dl1bz/ESP32-XPA125B-Webcontrol/XPA125B-MB-Assembly.pdf

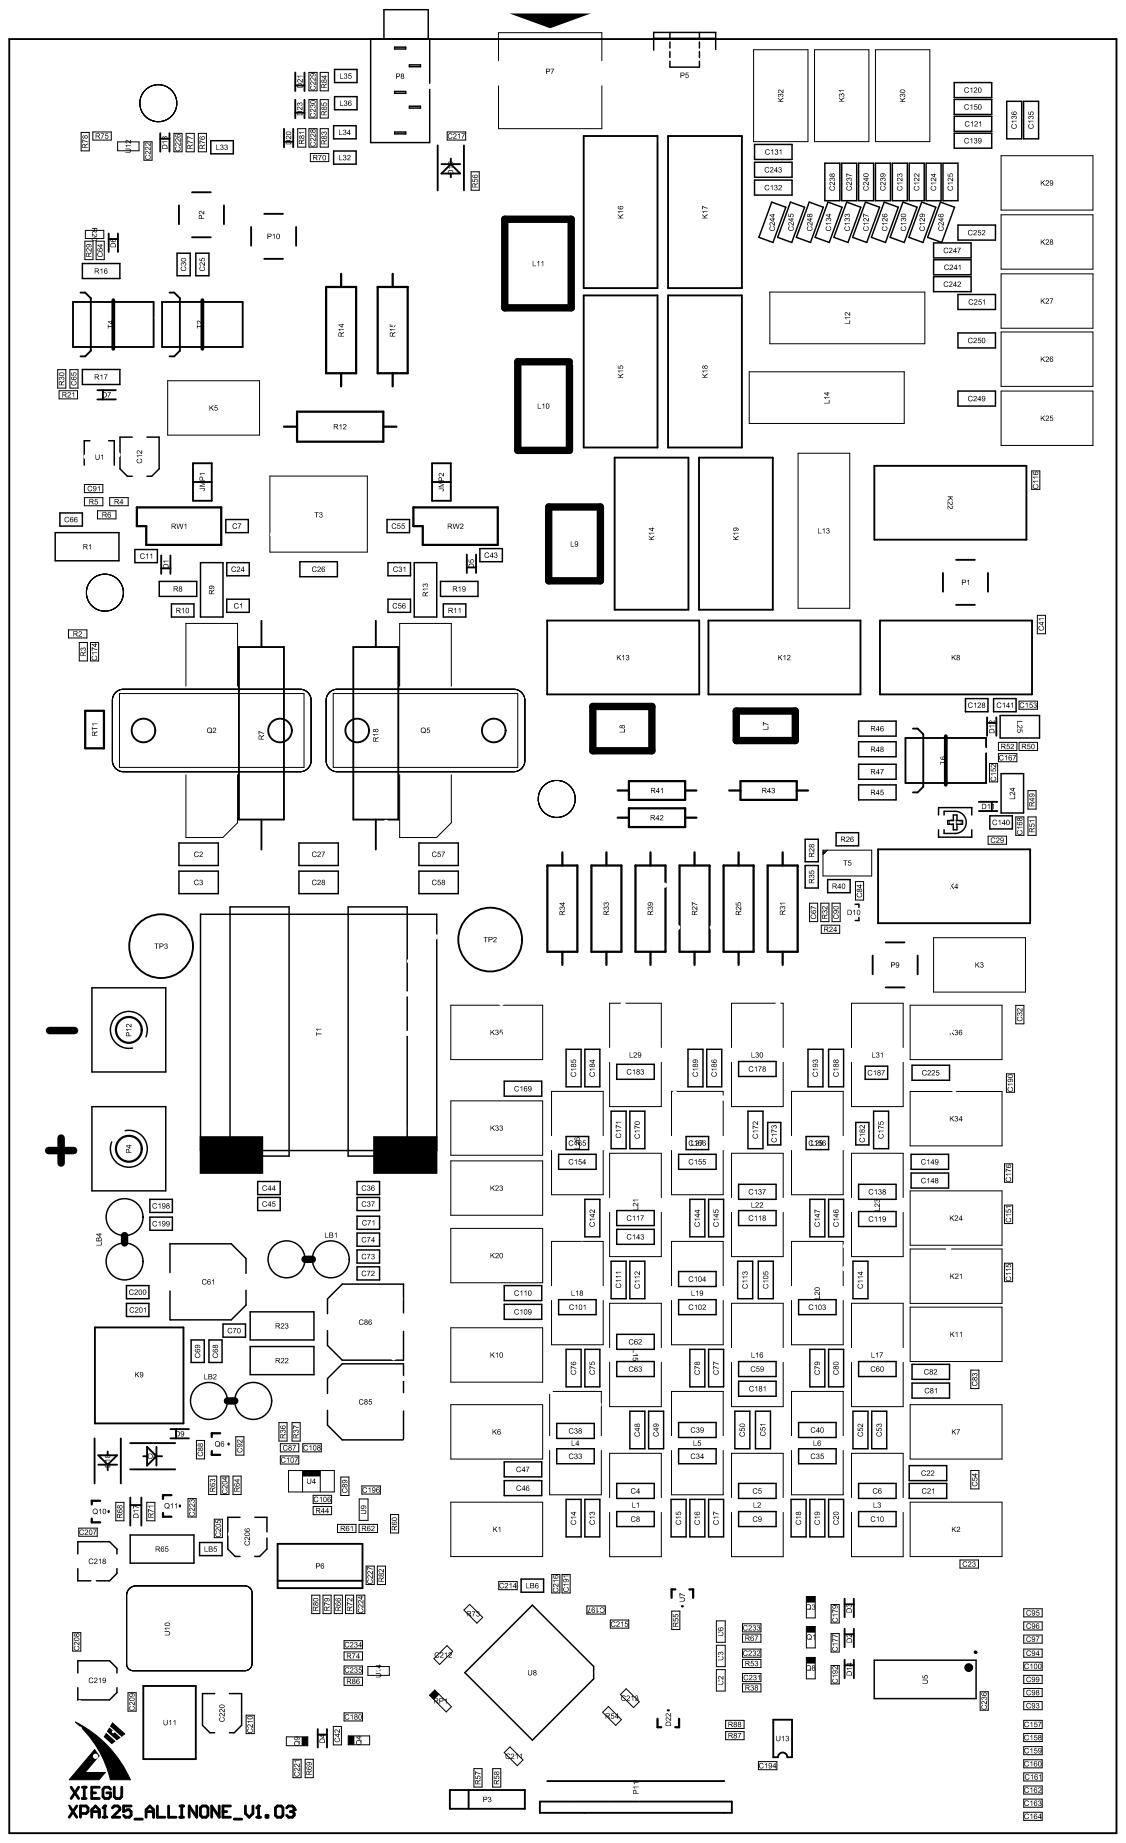
[picture p7: page 1]
