dl1bz/ESP32-XPA125B-Webcontrol/XPA125B-MB-Sch-V1_03.pdf

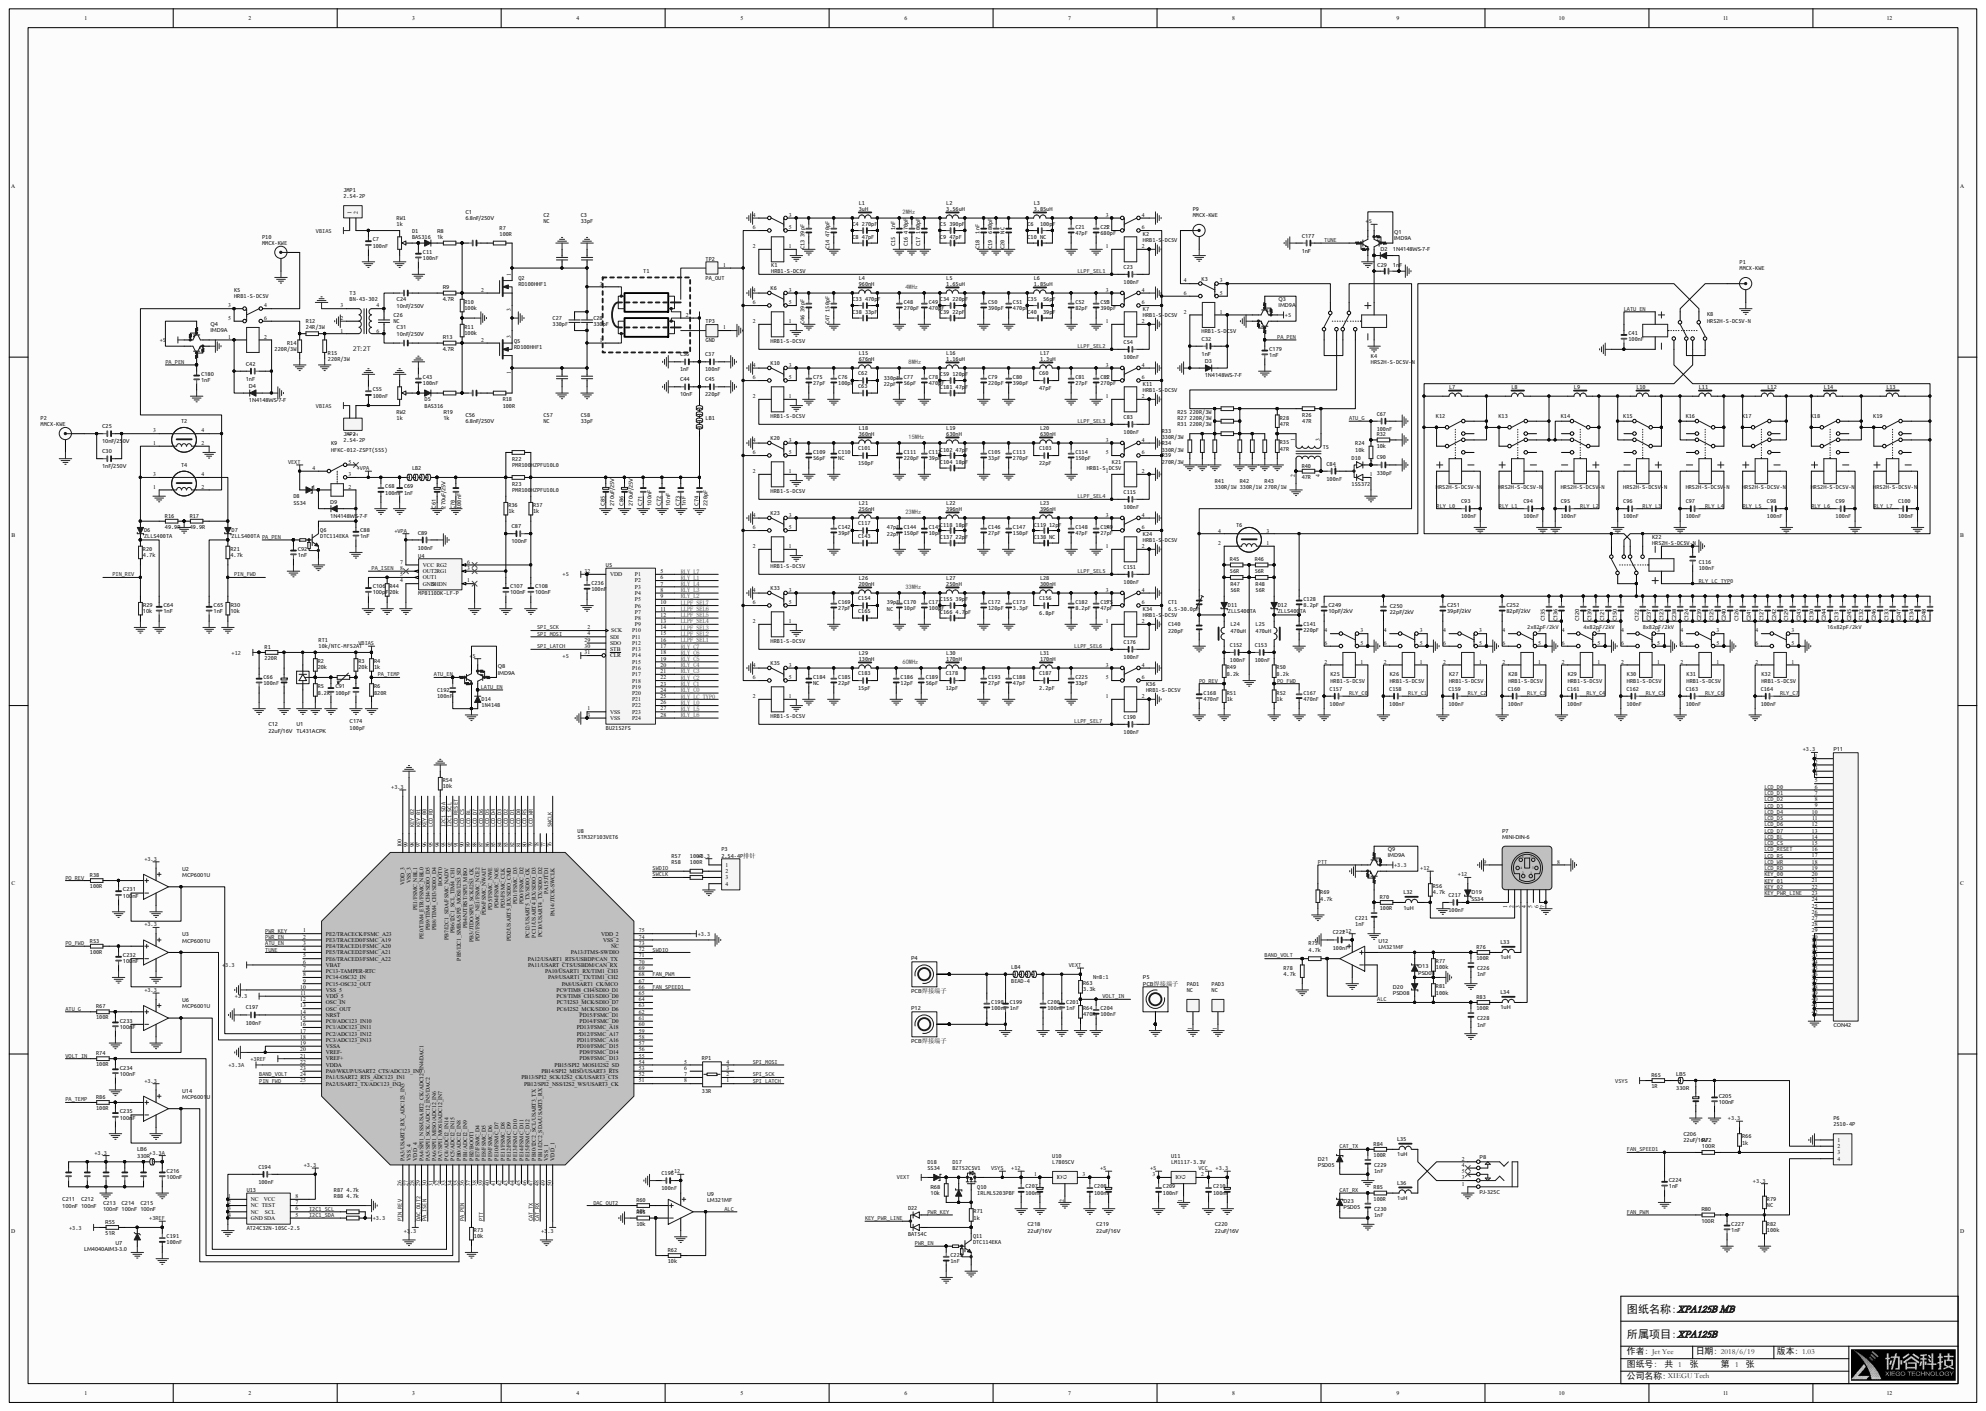
[picture p8: page 1]
