dl1bz/ESP32-XPA125B-Webcontrol/XPA125B_Mod_SWR_voltages.JPG

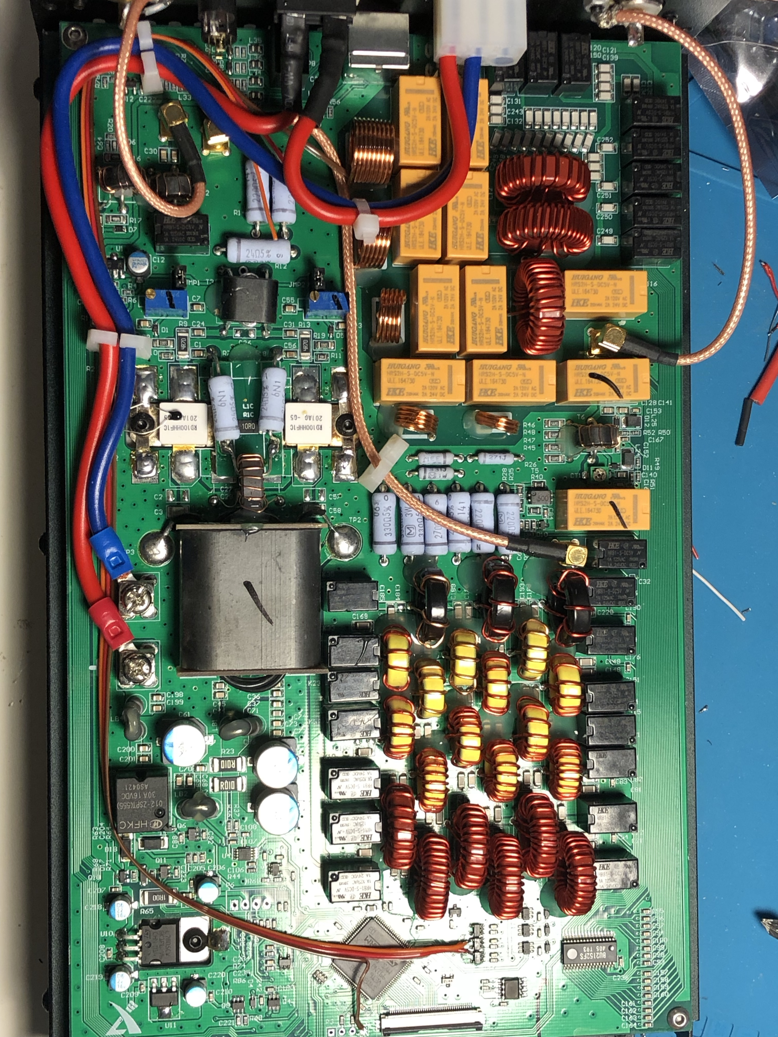
[picture p4: XPA125B_Mod_SWR_voltages.JPG]
XPA125B_Mod_SWR_voltages.JPG
