dl1bz/ESP32-XPA125B-Webcontrol/XPA125B_Mod_SWR_voltages_details.JPG

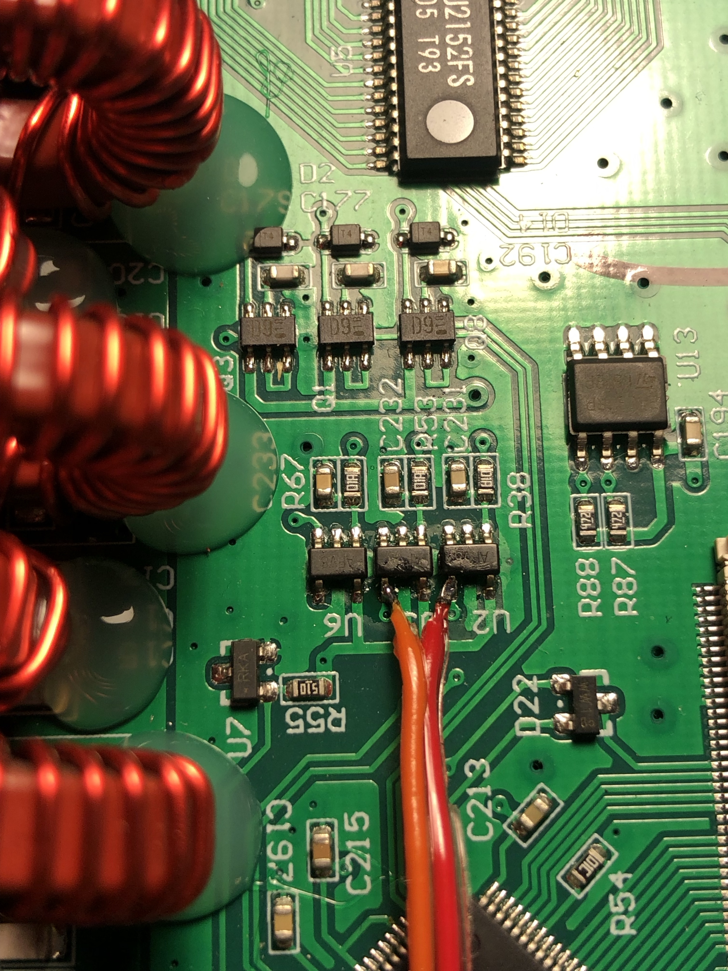
[picture p5: XPA125B_Mod_SWR_voltages_details.JPG]
XPA125B_Mod_SWR_voltages_details.JPG
